dcellucci/CSL-Part-Library/KICAD/csl-skidl/README.md

# Skullkid

An experiment: the design of a circuit board often explicitly defines the functionality of the microcontroller. Can a SKiDL program also generate a bootloader or sample C file that already has all of the required library functionality?

A savvy reader will have noticed 

## Frequently Asked Questions
### Why Skullkid?
Majora's Mask is incredible. Also, SKiDL looks kind of like Skullkid if you cross your eyes.
