dcellucci/CSL-Part-Library/FreeCAD/Servos/Hitec-5035HD/HS-45HB_Schematics1.jpg

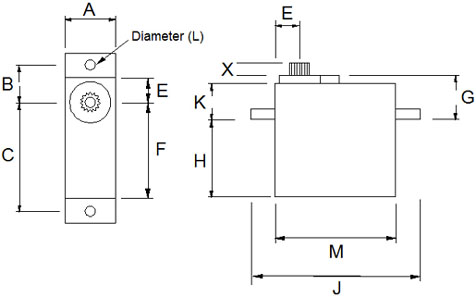
FreeCAD/Servos/Hitec-5035HD/HS-45HB_Schematics1.jpg
