dcellucci/CSL-Part-Library/KICAD/Prototypes/328PB_Breakout/CAM/328Breakout_traces.png

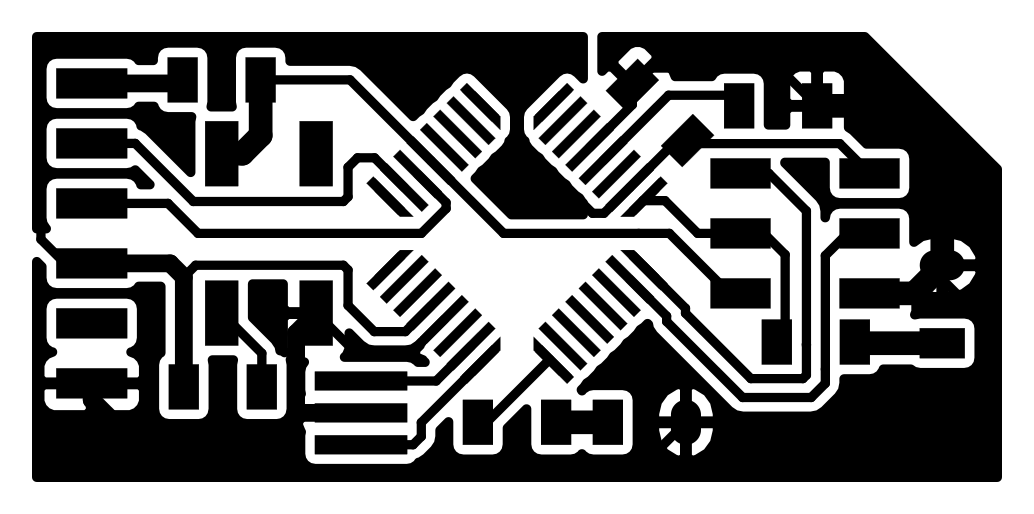
KICAD/Prototypes/328PB_Breakout/CAM/328Breakout_traces.png
