dcellucci/CSL-Part-Library/KICAD/Prototypes/ATSAMD11_Breakout/CAM/20170218_D11DBreakout_Cutout.png

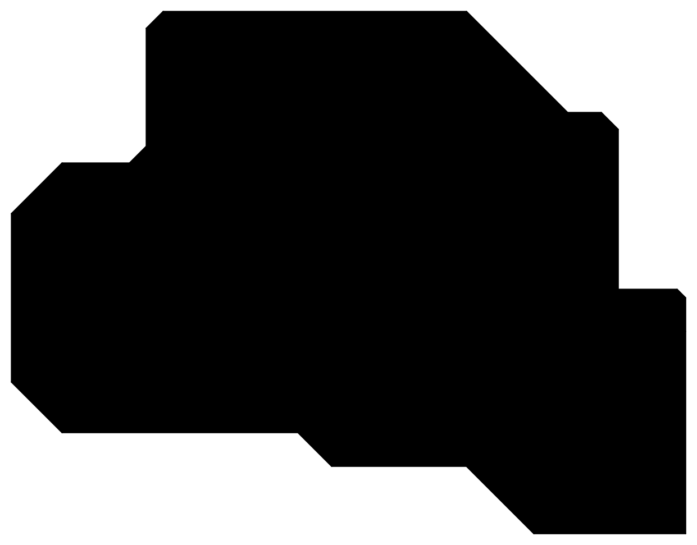
KICAD/Prototypes/ATSAMD11_Breakout/CAM/20170218_D11DBreakout_Cutout.png
