dcellucci/CSL-Part-Library/(list of files, cad)

Other CAD files:
5035CalibrationJig.3dm
