dcellucci/CSL-Part-Library/KICAD/Prototypes/APTP_Test/CAM/APTP_OUTPUT_TEST.pdf

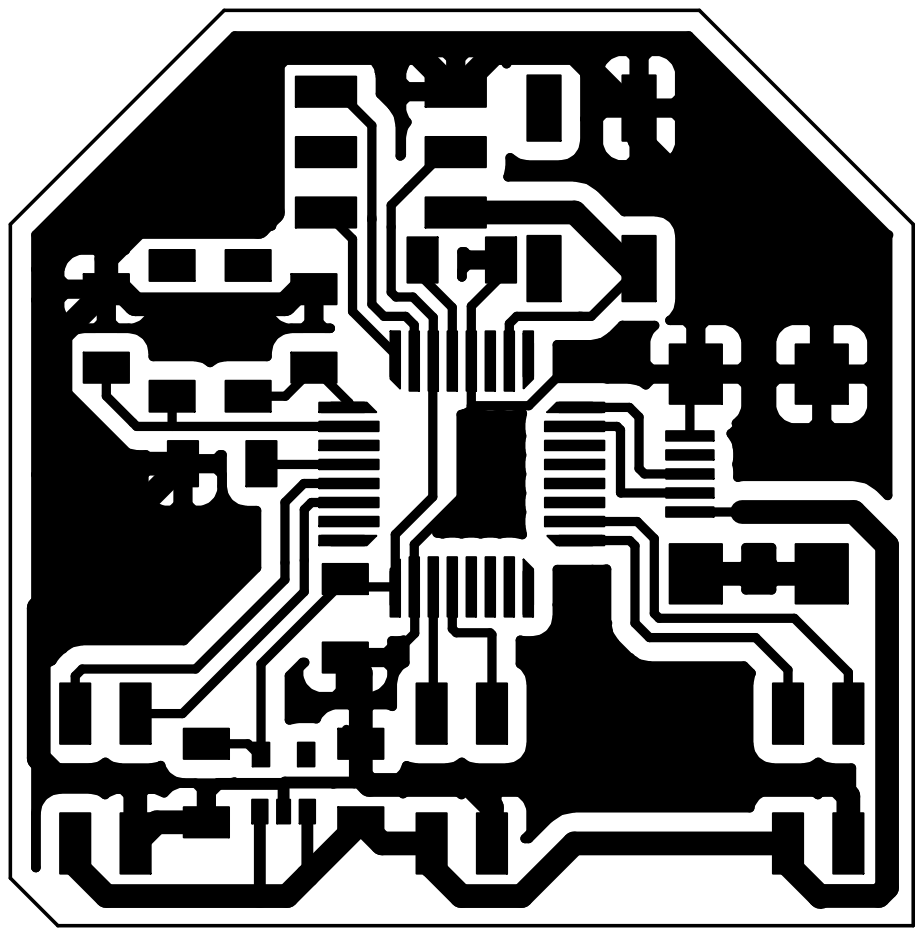
[picture p6: page 1]
