dcellucci/CSL-Part-Library/KICAD/Prototypes/ATSAMD11_Breakout/CAM/20170218_Base_Output.pdf

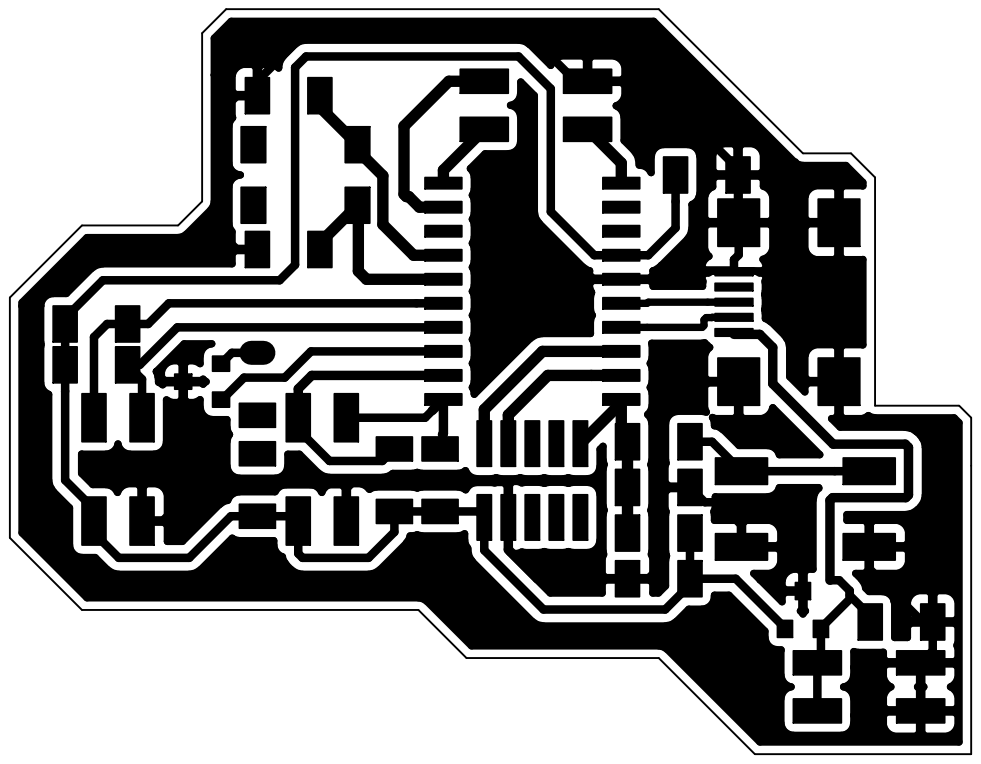
[picture p7: page 1]

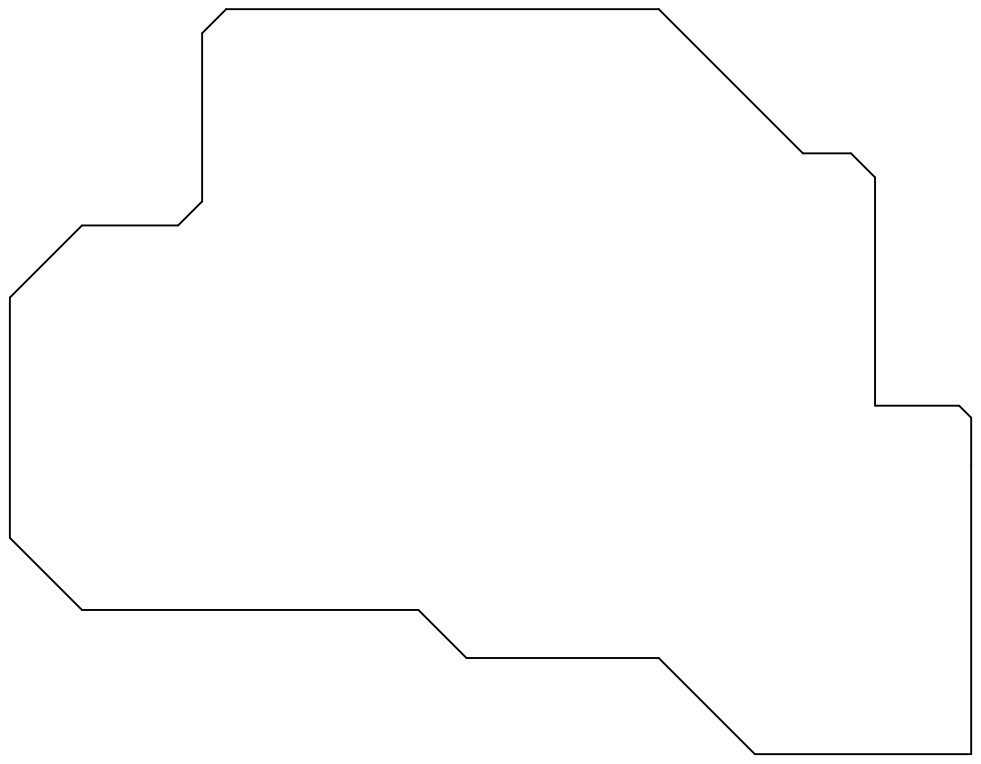
[picture p8: page 2]
