dcellucci/CSL-Part-Library/KICAD/Prototypes/328PB_Breakout/CAM/328PB_Breakout-F.Cu.pdf

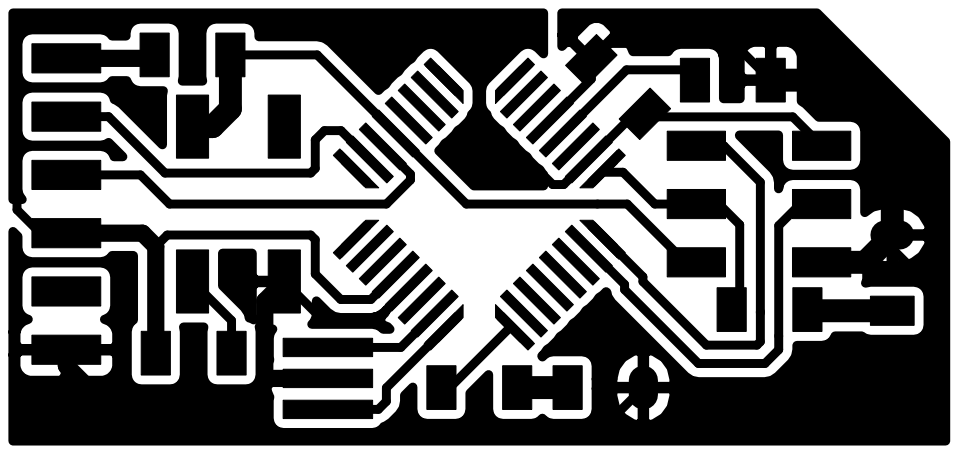
[picture p9: page 1]
