dcellucci/CSL-Part-Library/KICAD/Prototypes/ATSAMD11_Breakout/ATSAMD11_Breakout.kicad_pcb

## KiCad design KICAD/Prototypes/ATSAMD11_Breakout/ATSAMD11_Breakout.kicad_pcb (2017-04-04)

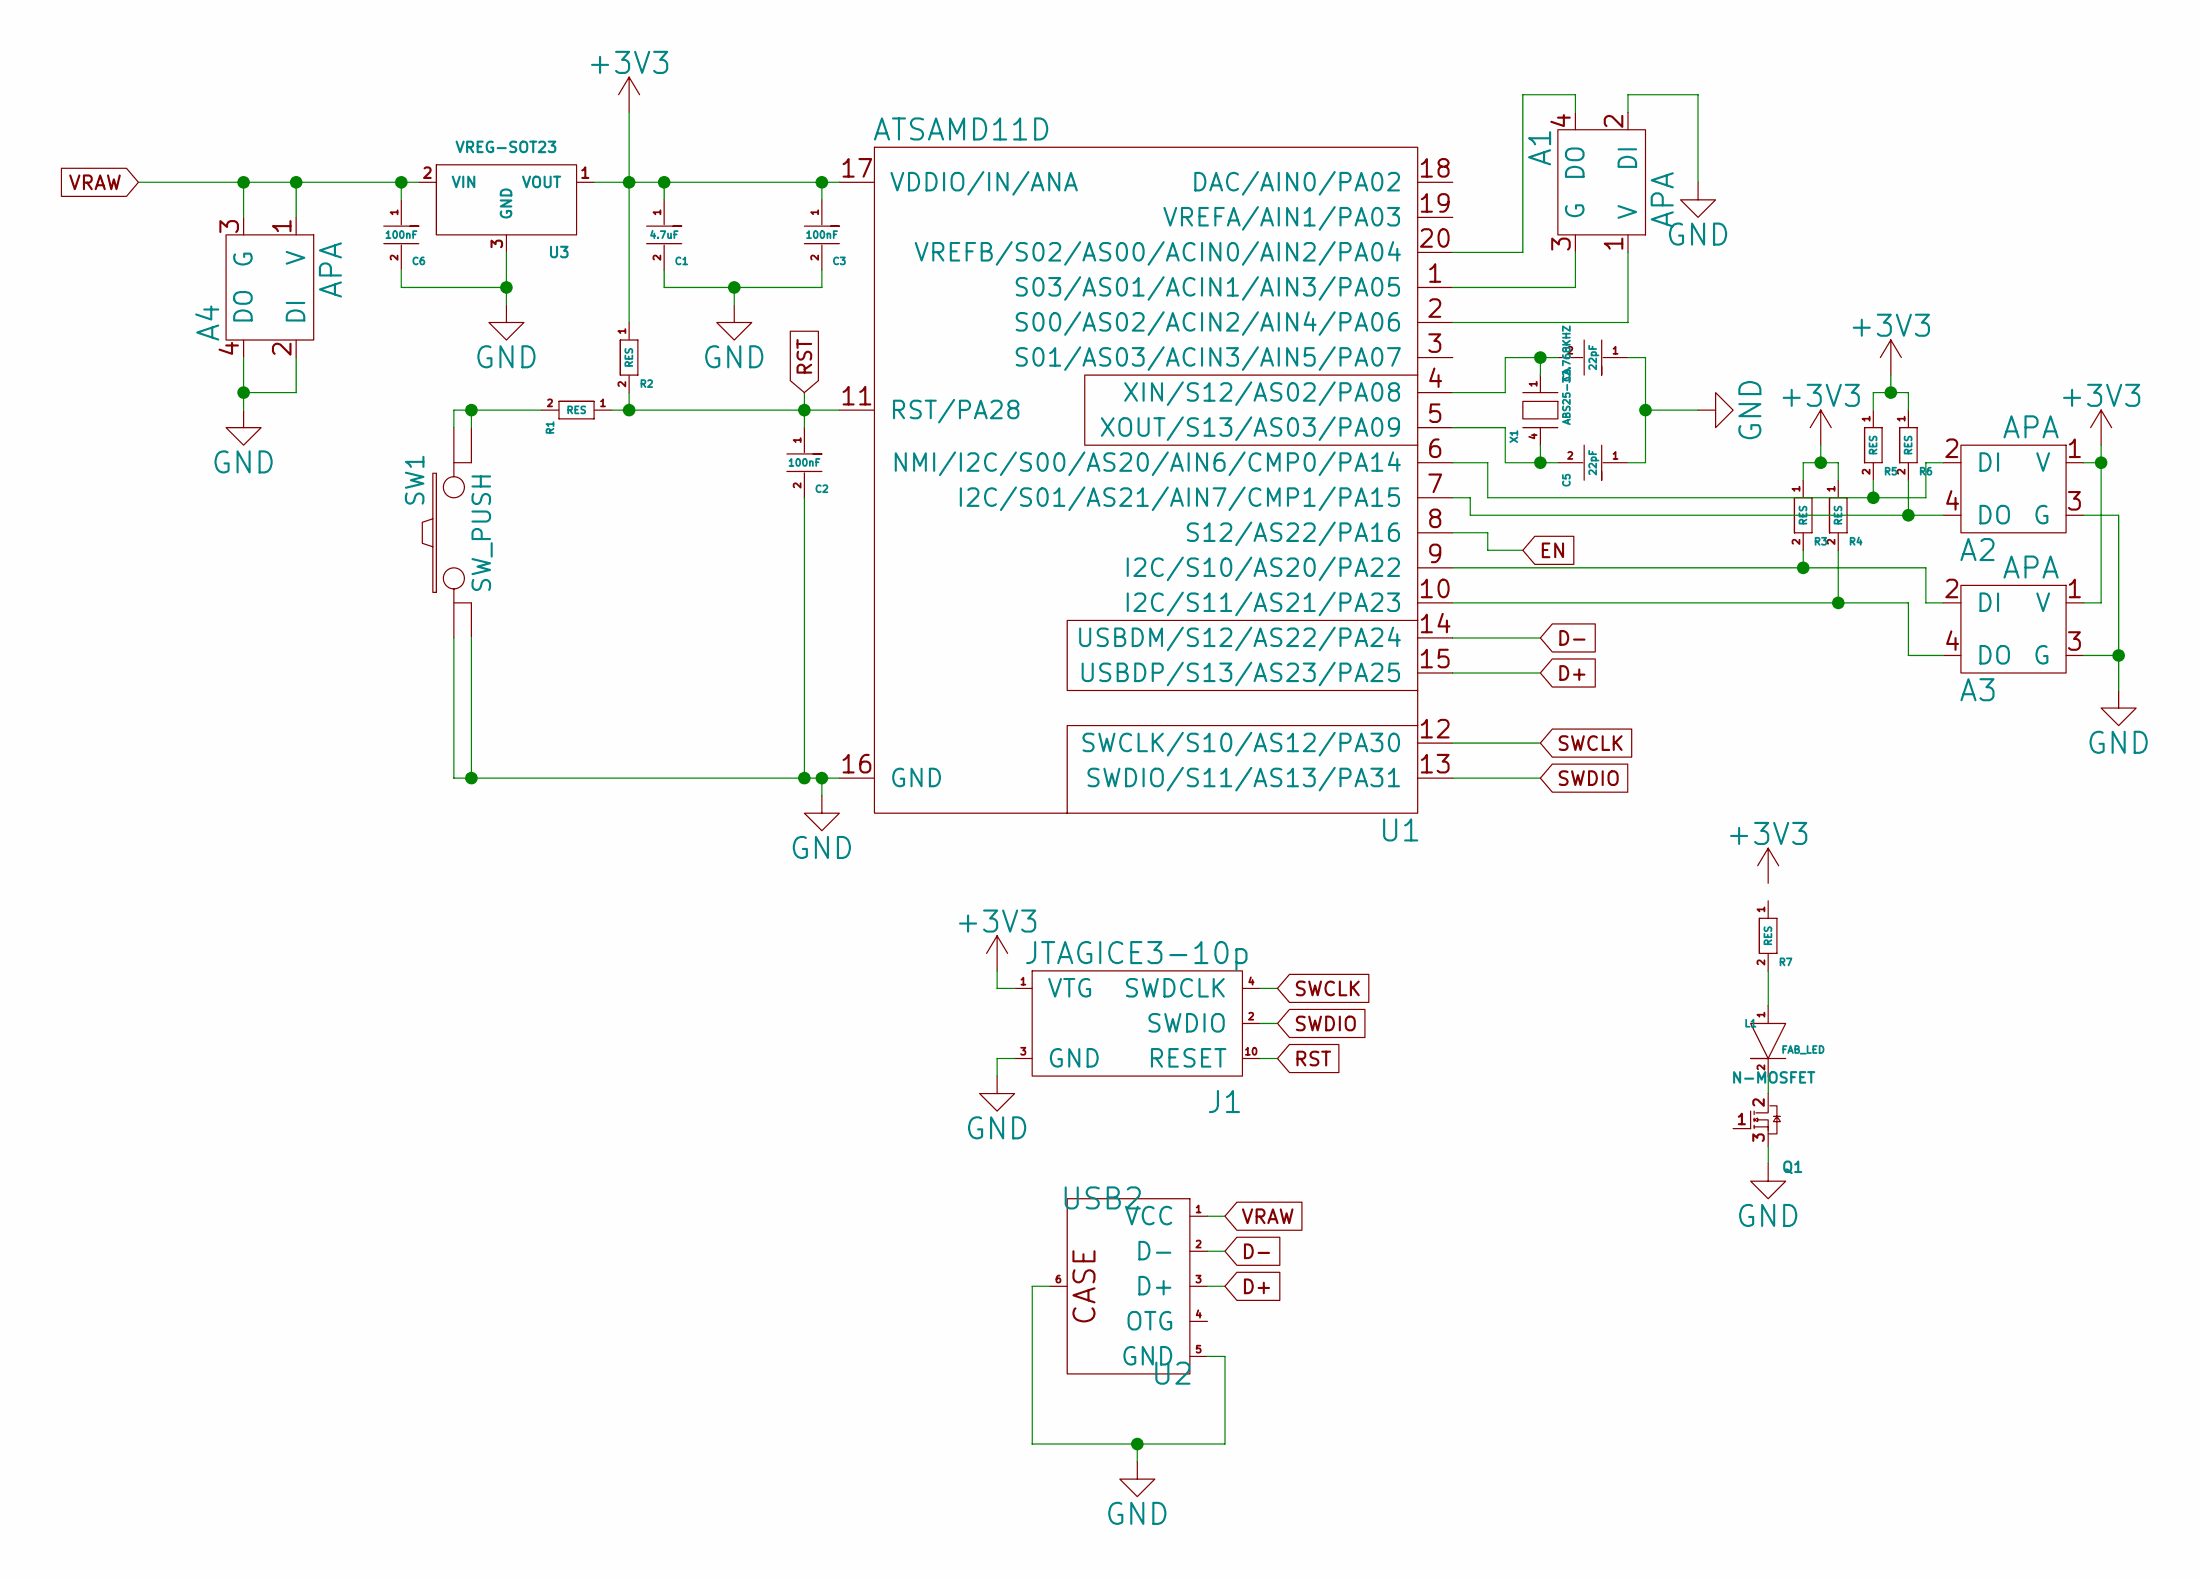
[picture p10: schematic ATSAMD11_Breakout.sch]

Parts:
A1, A2, A3, A4: APA; SMD-Header-2x2
C1: 4.7uF; CAP_1206_FAB
C2, C3, C6: 100nF; CAP_1206_FAB
C4, C5: 22pF; CAP_1206_FAB
J1: JTAGICE3-10p
L1: FAB_LED; LED_1206_FAB
Q1: N-MOSFET; SOT-23
R1, R2, R3, R4, R5, R6, R7: RES; CAP_1206_FAB
SW1: SW_PUSH; Switch-Tactile-B3SN-3112P
U1: ATSAMD11D; SOIC-20W_7.5x12.8mm_Pitch1.27mm
U2: USB2; USBMINIB2.0
U3: VREG-SOT23; SOT-23
X1: ABS25-32.768KHZ; 4-SOJ

Connections:
+3V3: A2.1 (V), A3.1 (V), C1.1, C3.1, J1.1 (VTG), R2.1, R3.1, R4.1, R5.1, R6.1, R7.1, U1.17 (VDDIO/IN/ANA), U3.1 (VOUT)
D+: U1.15 (USBDP/S13/AS23/PA25), U2.3 (D+)
D-: U1.14 (USBDM/S12/AS22/PA24), U2.2 (D-)
EN: Q1.1, U1.8 (S12/AS22/PA16)
GND: A1.2 (DI), A2.3 (G), A3.3 (G), A4.2 (DI), A4.4 (DO), C1.2, C2.2, C3.2, C4.1, C5.1, C6.2, J1.3 (GND), Q1.3, SW1.1, SW1.2, U1.16 (GND), U2.5 (GND), U2.6, U3.3 (GND)
unnamed: A1.1 (V), U1.2 (S00/AS02/ACIN2/AIN4/PA06)
unnamed: A1.3 (G), U1.1 (S03/AS01/ACIN1/AIN3/PA05)
unnamed: A1.4 (DO), U1.20 (VREFB/S02/AS00/ACIN0/AIN2/PA04)
unnamed: A2.2 (DI), R5.2, U1.6 (NMI/I2C/S00/AS20/AIN6/CMP0/PA14)
unnamed: A2.4 (DO), R6.2, U1.7 (I2C/S01/AS21/AIN7/CMP1/PA15)
unnamed: A3.2 (DI), R3.2, U1.9 (I2C/S10/AS20/PA22)
unnamed: A3.4 (DO), R4.2, U1.10 (I2C/S11/AS21/PA23)
unnamed: C4.2, U1.4 (XIN/S12/AS02/PA08), X1.1
unnamed: C5.2, U1.5 (XOUT/S13/AS03/PA09), X1.4
unnamed: L1.1, R7.2
unnamed: L1.2, Q1.2
unnamed: R1.2, SW1.3, SW1.4
RST: C2.1, J1.10 (RESET), R1.1, R2.2, U1.11 (RST/PA28)
SWCLK: J1.4 (SWDCLK), U1.12 (SWCLK/S10/AS12/PA30)
SWDIO: J1.2 (SWDIO), U1.13 (SWDIO/S11/AS13/PA31)
VRAW: A4.1 (V), A4.3 (G), C6.1, U2.1 (VCC), U3.2 (VIN)

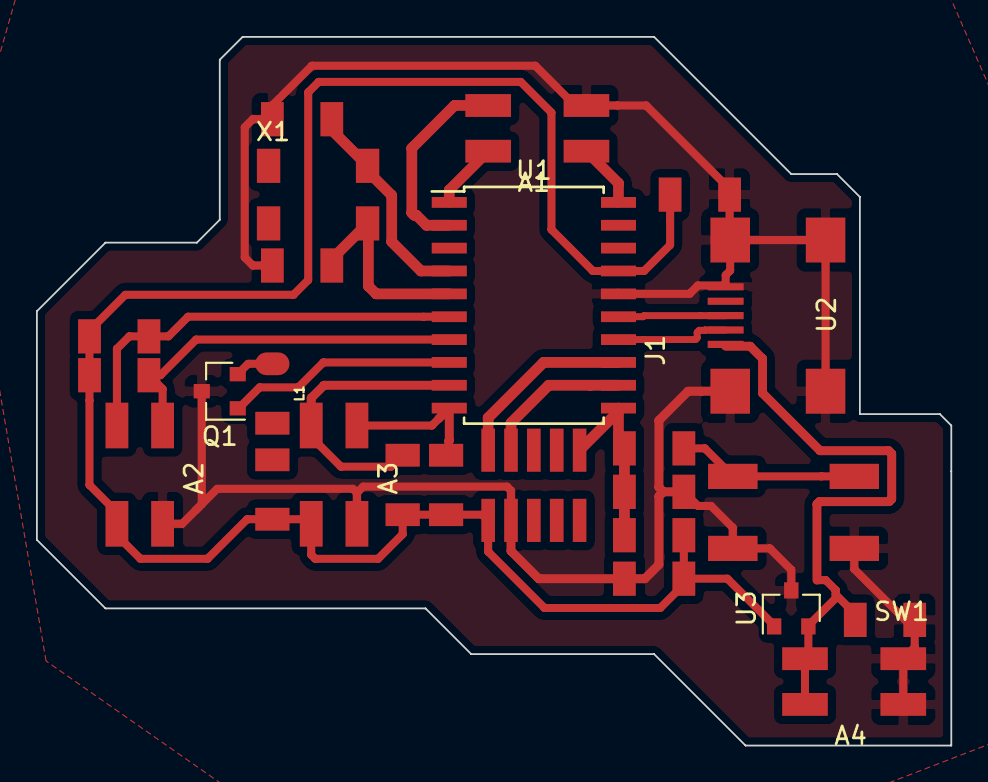
[picture p11: board ATSAMD11_Breakout.kicad_pcb from above]

Board: 2 copper layers, 50.8 x 39.4 mm, 25 parts (0 on the bottom side), 21 nets.
