dcellucci/CSL-Part-Library/KICAD/Prototypes/328PB_Breakout/328PB_Breakout.kicad_pcb

## KiCad design KICAD/Prototypes/328PB_Breakout/328PB_Breakout.kicad_pcb (2017-01-13)

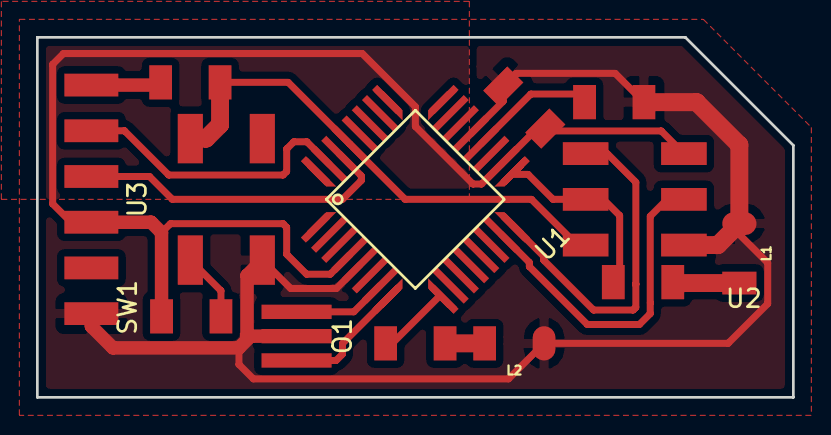
[picture p12: board 328PB_Breakout.kicad_pcb from above]

Board: 2 copper layers, 42.0 x 20.0 mm, 13 parts (0 on the bottom side), 15 nets.

Parts:
C1, C2, C3: 0.1uF; CAP_1206_FAB
L1, L2: FAB_LED; LED_1206_FAB
O1: RESONATOR
R1, R3: 330; CAP_1206_FAB
R2: 10k; CAP_1206_FAB
SW1: SW_PUSH; Switch-Tactile-B3SN-3112P
U1: ATMEGA328PB; TQFP-32-Fab
U2: AVRISP; SMD-Header-3x2
U3: FTDI; SMD_RA_1x06_No_Holes

Connections:
+5V: C1.1, R2.1, U1.4, U1.18, U2.2, U3.3
DTR: C3.1, U3.6
GND: C1.2, C2.2, L1.2, L2.2, O1.2, SW1.3, SW1.4, U1.5, U1.21, U2.6, U3.1
MISO: U1.16, U2.1
MOSI: U1.15, U2.4
unnamed: C2.1, U1.20
unnamed: L1.1, R1.2
unnamed: L2.1, R3.2
unnamed: O1.1, U1.8
unnamed: O1.3, U1.7
unnamed: R3.1, U1.9
RESET: C3.2, R2.2, SW1.1, SW1.2, U1.29, U2.5
RX: U1.30, U3.4
SCK: R1.1, U1.17, U2.3
TX: U1.31, U3.5
