dcellucci/CSL-Part-Library/KICAD/Prototypes/APTP_Test/CAM/20170105_APTP_CAM_Traces.png

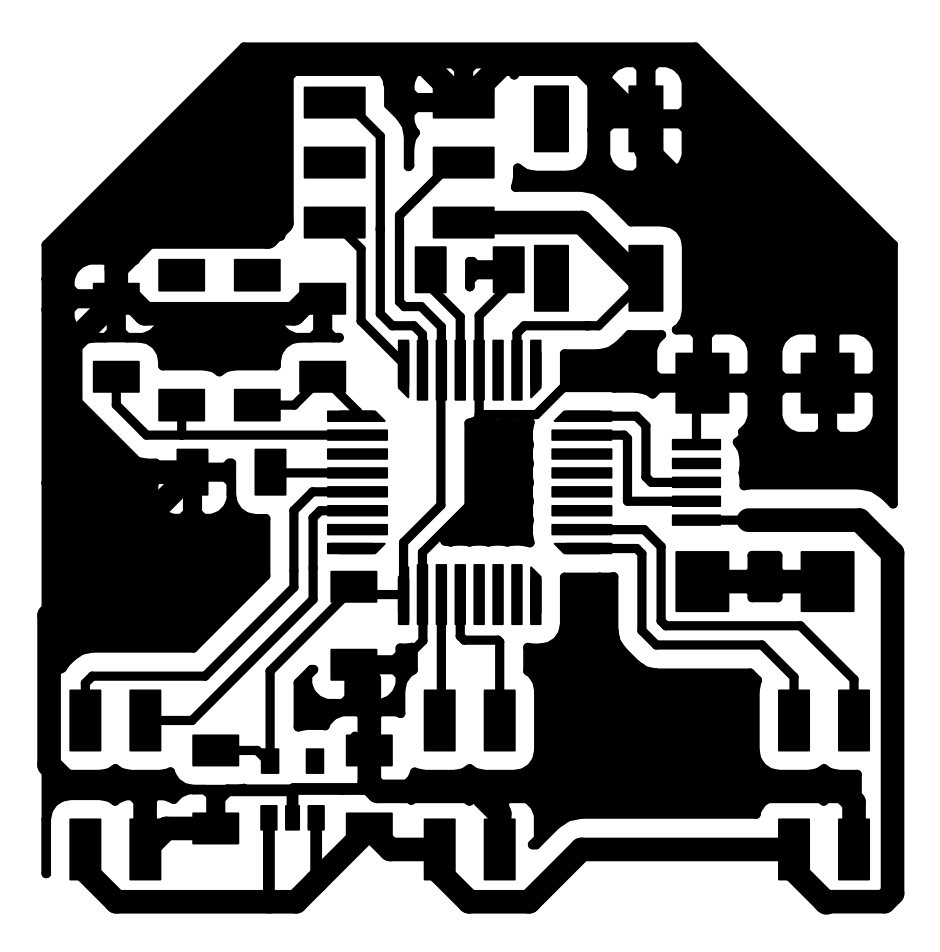
KICAD/Prototypes/APTP_Test/CAM/20170105_APTP_CAM_Traces.png
