dcellucci/CSL-Part-Library/KICAD/Prototypes/APTP_Test/CAM/APTP_OUTPUT_TEST.png

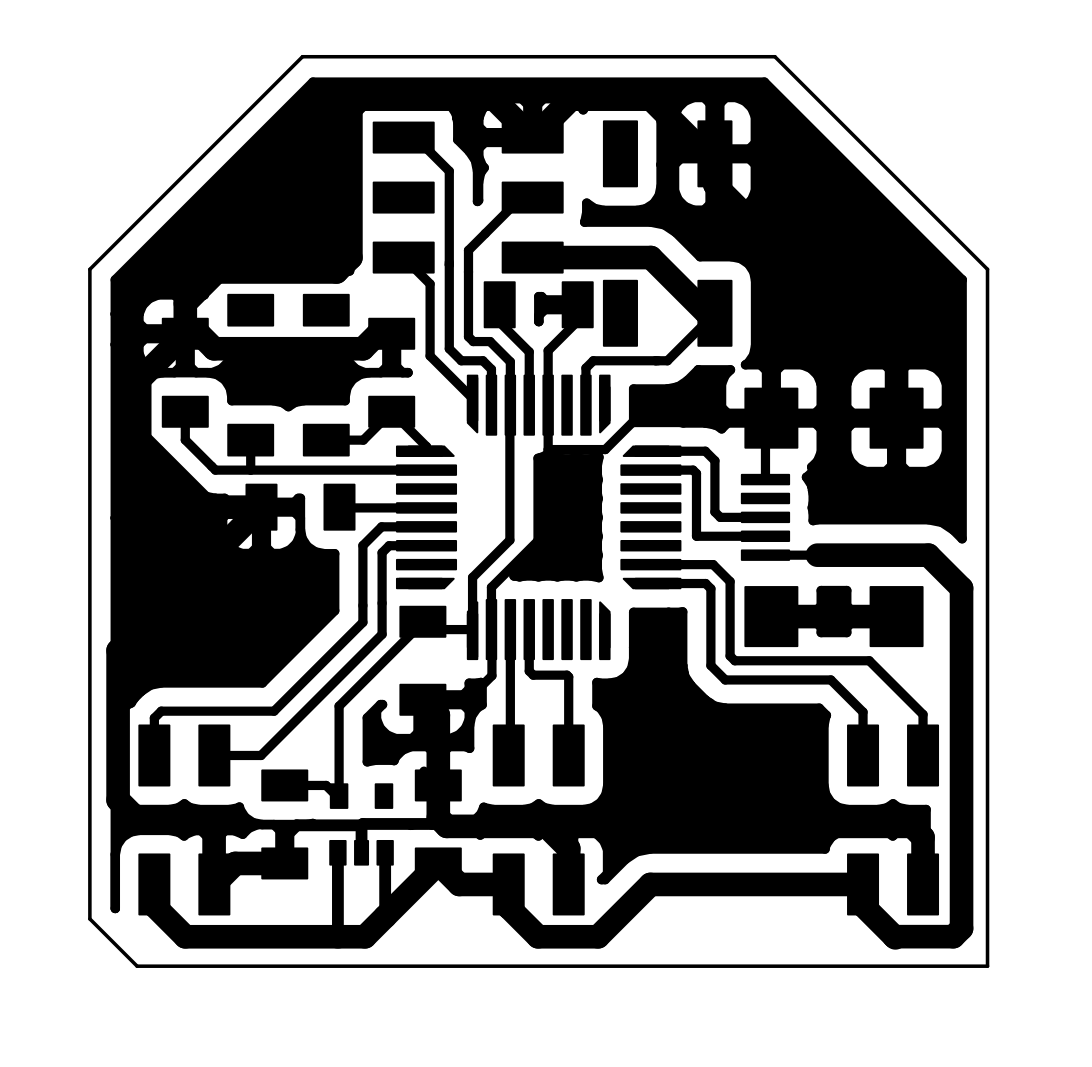
KICAD/Prototypes/APTP_Test/CAM/APTP_OUTPUT_TEST.png
