dcellucci/CSL-Part-Library/(commit log)

2016-11-20 first KiCad library things
2016-12-25 Split up CSL libraries
    [APTP_TEST.kicad_pcb, APTP_TEST.sch]
2016-12-27 Added a new library for specifically non hand-solderable footprints
2017-01-10 Added an experiment + APA test board
    [APTP_TEST.sch, ATSAMD11_Breakout.sch]
2017-01-11 Added 328PB breakout
    [328PB_Breakout.kicad_pcb, 328PB_Breakout.sch, _saved_328PB_Breakout.sch]
2017-01-12 rerouted 328pb breakout
    [328PB_Breakout.kicad_pcb]
2017-01-20 Added DPS310 library
    [328PB_Breakout.kicad_pcb, 328PB_Breakout.sch, _saved_328PB_Breakout.sch]
2017-02-09 Added Power and MOJO parts
2017-02-09 Added ATSAMD11 breakout
    [ATSAMD11_Breakout.kicad_pcb, ATSAMD11_Breakout.sch]
2017-02-10 Provided clearance for USB cable
    [ATSAMD11_Breakout.kicad_pcb]
2017-04-04 added RTC library, board defs derived from Mattairtech
    [ATSAMD11_Breakout.kicad_pcb, ATSAMD11_Breakout.sch, SAMD11C14A.cfg, SAMD11D14AM.cfg, SAMD11D14AS.cfg, SAMD21E15A.cfg, SAMD21E16A.cfg, SAMD21E17A.cfg]
2017-04-21 added servo calibration jig + APA lib v0
    [5035CalibrationJig.3dm]
